ThomasWenzler/Garden-Irrigation-Arduino/README.md

# Garden-Irrigation-Arduino
Irrigation system for private gardens controlled by Arduino and mobile phone

The system consists of power supplies, relays for controlling hydraulic valves, a soil moisture sensor, an arduino with ethernet shield and at least one device (mobile phone, desktop PC, etc.) in the LAN/WLAN as user interface. It controls the irrigaion fully automized. 
Files: 
- Gießcomputer_Spec_V1.0.pdf: System specification and design document; includes SW description on concept level, initial setup information and user manual
- arduino source code files
