ThomasWenzler/Garden-Irrigation-Arduino/90_Stub.ino

/*
void GetTime_MezAsCharArray(byte *Mez, char* buf) {
  
}*/

// file Irrig
/*
void FcnsDeleteString(char* charArray, int lengthcharArray) {
  
}


char Irrig_ModeDisplayStringHeadl[] = "stub1";
char Irrig_ModeDisplayStringDetail[] = "stub2";
*/
